lawchli/Spar/pcb/previews/back-3d-detail.png

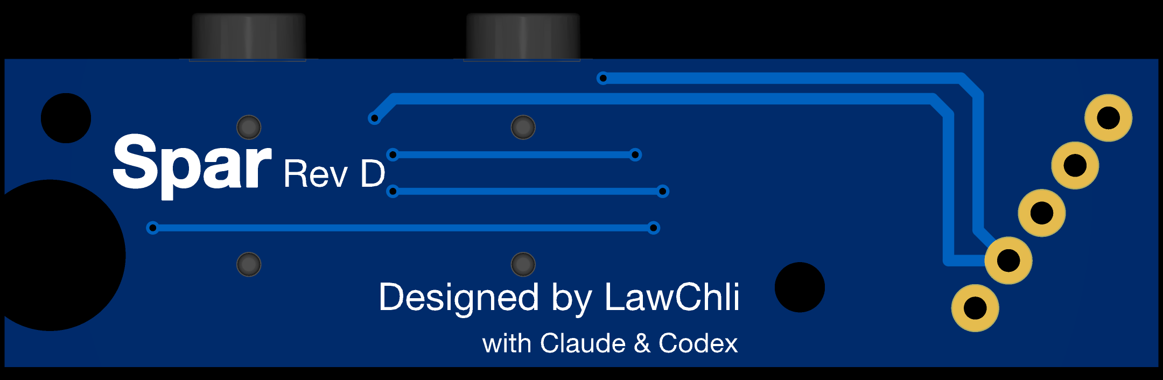
pcb/previews/back-3d-detail.png
