lawchli/Spar/pcb/previews/front-3d-detail.png

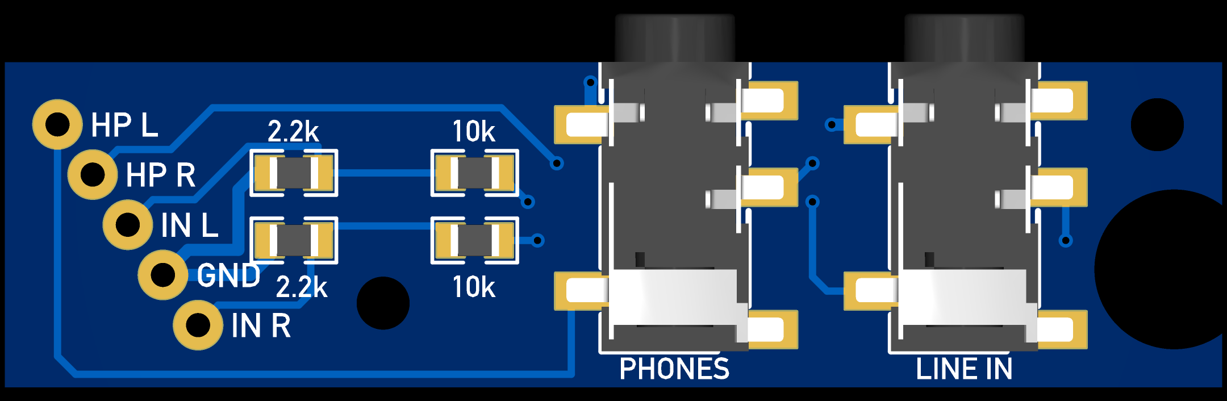
pcb/previews/front-3d-detail.png
