lawchli/Spar/pcb/previews/front-3d-perspective.png

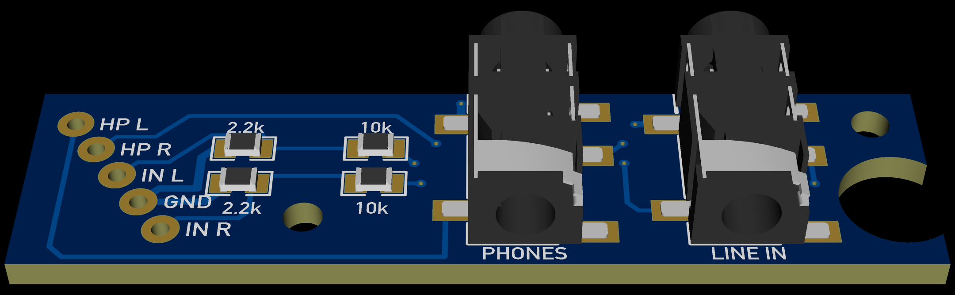
pcb/previews/front-3d-perspective.png
