lawchli/Spar/pcb/previews/layout-2d-detail.png

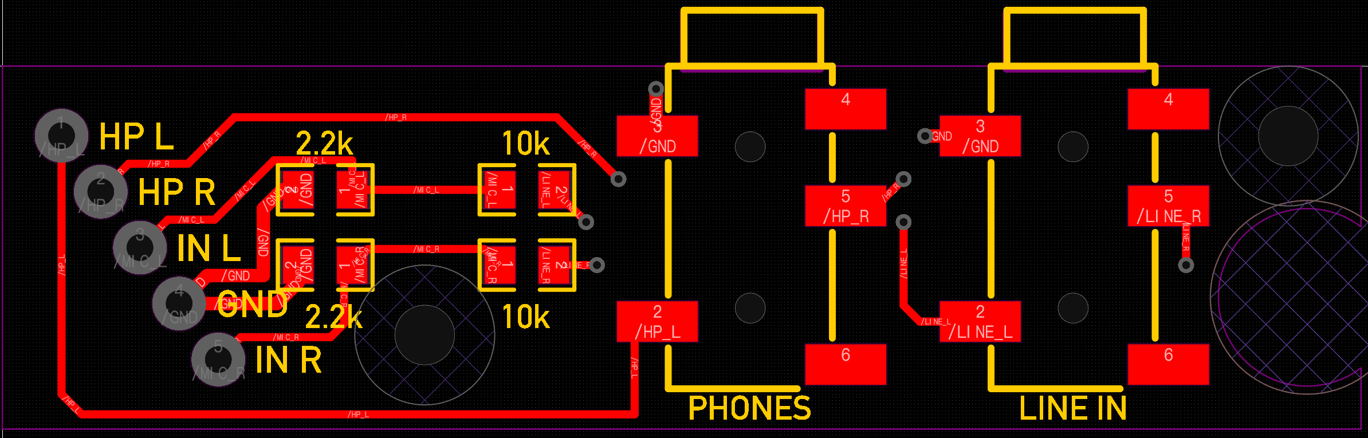
pcb/previews/layout-2d-detail.png
