lawchli/Spar/pcb/previews/layout-2d.png

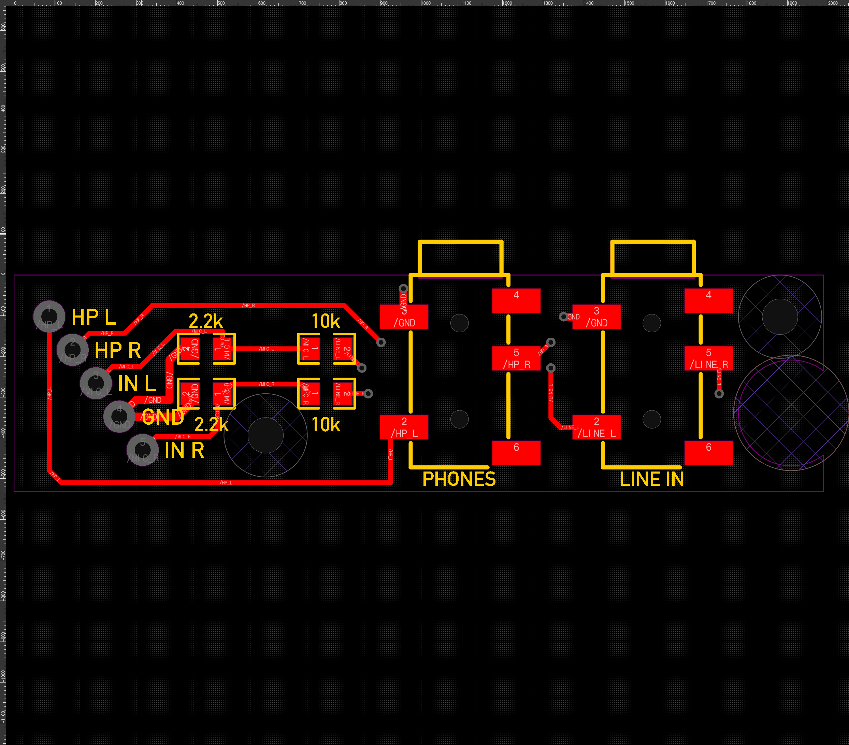
pcb/previews/layout-2d.png
