lawchli/Spar/(commit log)

2026-10-20 software v0.1: diagnostic kit
    Read-only tools for finding out how the phone detects a wired headset
    and where its microphone input is routed: a root snapshot, a
    timestamped event watcher, mixer and PCM capture helpers, the Probe
    app that checks the actual input route, and TinyALSA 2.0.0 built
    with the NDK.
2026-10-20 software v0.2: mono line input through the headset mic contact
    A line-level source is detected as a headset microphone once the mic
    contact sees a 2.2 kOhm DC load, with 47 kOhm in series to drop the
    level. Adds MONO-LINE-IN.md: how the headset detection decides, the
    circuit, recordings with the MIC and UNPROCESSED sources, the USB
    input channel-mask issue, and the conditions for stereo. Fixes su -c
    quoting in the XML collector and the watcher.
2026-10-20 software v0.3: stereo capture on the 5-pole jack
    Records two independent line inputs through the two microphone
    contacts of a 5-pole jack, with codec-internal headphone monitoring.
    - jackguard: filters the 5-pole switch event (SW 0x12) that makes
    Android 16 abort system_server
    - binaural-mixer.sh: vendor binaural-mic route to a two-channel PCM,
    monitoring on/off, restore
    - vcap / vmix: capture and mixer writes through the phone's own
    libtinyalsa, since TinyALSA 2.0.0 tinycap loses data on this kernel
    - level-test, raw_metrics, howl-sweep, jack-compare-snap
    - tinycap: stop on read errors, read one period at a time
    - STEREO-CAPTURE.md: pinout, detection, routing, channel check,
    monito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
2026-10-20 pcb: Rev B, direct-plug board (48 x 13.5 mm)
    The board now sits in a small box on top of the phone, jacks facing up,
    with the bare 5-pole plug wired to it inside the box. Jacks moved
    0.5 mm towards the board edge so their mouths clear the board.
    [kicad-positions.csv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]
2026-10-20 pcb: Rev A, cable splitter board (35 x 15 mm)
    KiCad 10 project, generator and check scripts, Gerbers, BOM and
    placement file, ERC/DRC reports and renders.
    [BOM.csv, kicad-positions.csv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]
2026-10-20 pcb: breadboard and hand-wired build
    Wiring diagram and build notes for the input network at its final
    values (10 kOhm series, 2.2 kOhm to ground per channel, star ground),
    before any PCB.
2026-10-20 pcb: Rev C-M2, jacks grouped next to the plug
    Shorter lever on the plug when cables are plugged in: both jacks move
    next to the plug, the wire pads move to the right, R1/R2 rotate and
    the M2 holes move. Circuit, star ground and rules unchanged.
    [kicad-positions.csv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]
2026-10-20 pcb: Rev B-M2, two M2 mounting holes
    The two 1.6 mm locating holes become 2.2 mm holes for M2 screws, with
    a 5.2 mm copper keep-out, to mount the board in the first enclosure.
    [xz1-direct-B_Cu.gbl, xz1-direct-B_Mask.gbs, xz1-direct-B_Silkscreen.gbo, xz1-direct-Edge_Cuts.gm1, xz1-direct-F_Cu.gtl, xz1-direct-F_Mask.gts, xz1-direct-F_Paste.gtp, xz1-direct-F_Silkscreen.gto]
2026-10-20 pcb: Spar Rev D, redrawn natively in EasyEDA Pro
    50.5 x 13.5 x 1.6 mm, 0805 resistors for hand soldering, right-edge
    notch for the lid post, M2 holes on the diagonal, jacks next to the
    plug. EasyEDA Pro project backup with schematic and layout, the
    five-wire pad library, netlists, renders and BOM. Fabrication files
    follow when the board is ordered.
    [BOM.csv, kicad-positions.csv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]
